nonas-hunter/3D-scanner/docs/MP2_PIE.pdf

# Mini-Project 2: DIY 3D Scanner

## Elisa Dhanger, Jennifer Lee, Luke Nonas-Hunter

## Section 3+4: Group 58

9/16/21

### Abstract

In this project, we were tasked to create a mechanism that could scan a 3D object (in this case a cardboard cutout of a letter) and create a visualization for it. We used 2 servo sensors, an infrared distance sensor, and an Arduino for the electrical/mechanical component of this project. The mechanical support structures were 3D printed, and everything was coded in Arduino and python through VScode.

## 1 Procedure

## 1.1 Circuit

To begin, we started by connecting the necessary components to the Arduino. We were required to use two servo motors and an infrared distance sensor. We connected the servos to pin 9 and 10, and we connected the infrared distance sensor to analog pin 0 since we needed to receive a set of continuous data (Figure 1).

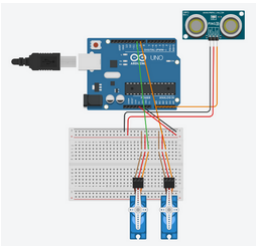
[picture p3: figure]

Figure 1: Circuit Diagram of setup.

After setting up the circuit, we started to run some calibration data for the sensor. The data that the Arduino was reading does not directly translate to distance, and in addition, we knew that the relationship between the analogRead() data and actual distance was not a direct linear relation. Therefore, we set up the sensor against a tape measure and recorded the analogRead() data at several distances across 0-28 inches into a spreadsheet and graphed out the data. Based on the results of these findings, we were able to calculate a line of best fit which would serve as the calibration curve (Figure 2).

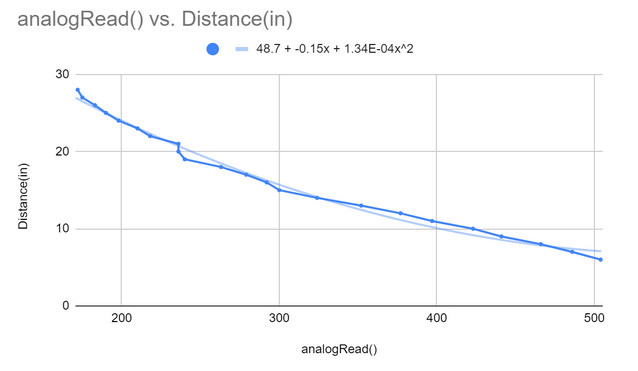
[picture p4: figure]

Figure 2: Calibration plot depicting relationship between the analogRead() data and the actual distance.

After setting up our calibration curve, we also were tasked to create an error plot to test how accurate the calibration curve is by taking measurements at certain distances and comparing the analogRead value for the actual distance vs. the predicted distance through the line of best fit (Figure 3). We had come to the conclusion that the distance was pretty accurate based on how low the error is, and that we could continue onto the next step.

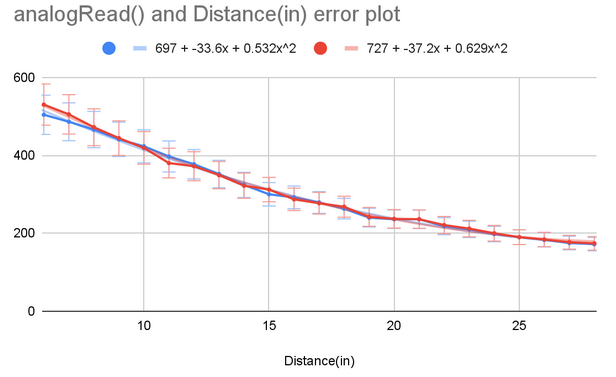
[picture p5: figure]

Figure 3: Error plot of calibration data.

## 1.2 Mechanism

For the 3D scanner, we had to build a pan-tilt mechanism to allow the infrared distance sensor to record distances from different yaws and pitches. This allows us to have enough data points to build a visualization of the object scanned.
To create the pan-tilt mechanism we started by creating sketches (Figure 4) of different pan-tilt mechanisms. We then used those sketches to start creating the CAD in SolidWorks. We started by creating the base of the pan-tilt (part 1) and our first iteration had the servo motor body centered in a cylinder (Figure 5).

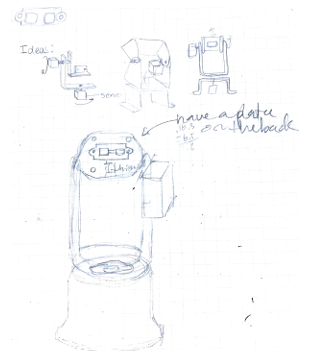
[picture p6: figure]

Figure 4: Sketches of different possible pan-tilt ideas to build.

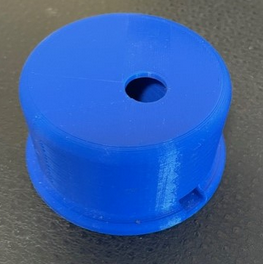
[picture p7: figure]

Figure 5: Part 1 with the servo motor centered and the shaft off-center (3D printed).

We realized after printing the piece that having the servo motor centered caused the shaft to be off-center meaning the next part of the pan-tilt that attached to the shaft would spin off-center. To fix this we centered the shaft of the servo motor (Figure 6).

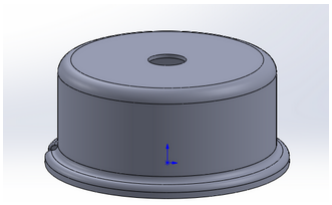
[picture p8: figure]

Figure 6: SolidWorks CAD model of part 1 with a centered shaft.

After creating the base we began designing the part that attaches to the shaft of the first servo motor (part 2). This part was made to have two arms that come up from the sides that have a hole on one side for a metal pin and a hole on the other side for the shaft of the servo motor. These would make it able to be able to hold and have the sensor-holder (part 3) rotate (pitch). We also added a motor case on one side of the part to better hold the second servo motor and have a place to screw it into the device. The first iteration of this part was too bulky (Figure 7) and so we redesigned this part to be thinner and not have a fully circular base but only a section of a circle (Figure 8).

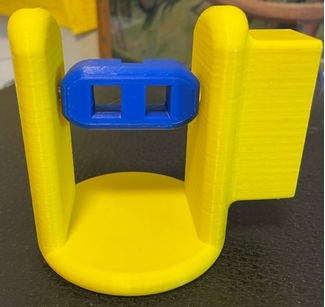
[picture p9: figure]

Figure 7: Part 2 edition 1 with thicker arms and a round base.

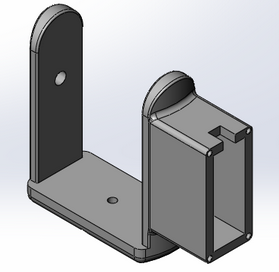
[picture p10: figure]

Figure 8: SolidWorks CAD model of part 2 with thinner arms and a cut-down base.

To then hold and rotate the sensor we created a sensor-holder that has a spot to screw the servo motor’s horn to the sensor holder. It also has a spot to press-fit the metal pin through part 2 to part 3 (Figure 9).

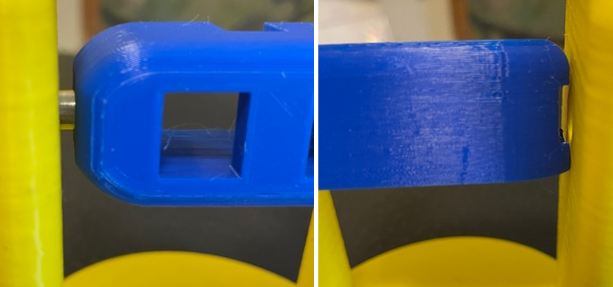
[picture p11: figure]

Figure 9: On left shows where the metal pin con-nects part 2 and part 3 together. On right shows where the motor horn would meet with part 3.

Due to the fact we redesigned part 2 we then had to redesign part 3 to be longer so it would fit better with the thinner part 2 (Figure 10).

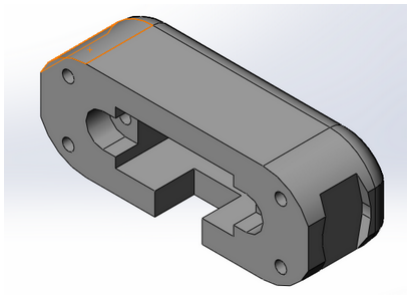
[picture p12: figure]

Figure 10: Final SolidWorks CAD model of part 3: the sensor holder.

For final touches, we created two covers, one for the sensor holder and one for part 2’s servo motor holder (Figure 11).

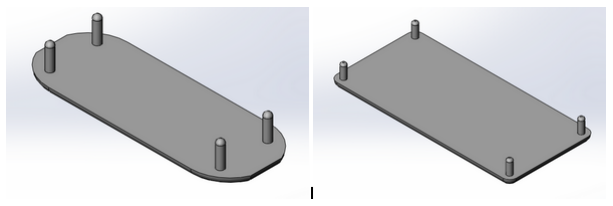
[picture p13: figure]

Figure 11: On the left is the sensor cover for part
3. On the right is the servo motor cover for part 2.

Throughout this process, we created an assembly that allowed us to make sure that parts we lining up correctly and fit together. We have Figure 12 to show the final assembly in SolidWorks of all of the parts mated together.

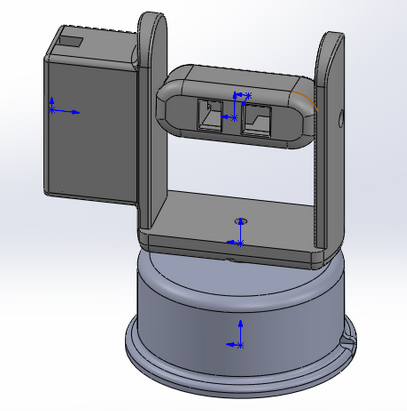
[picture p14: figure]

Figure 12: Shows the full assembly of parts 1,2,3 and the sensor and servo motor covers .

To fabricate the parts we used 3D printing because each of the parts are strangely shaped and hard to manufacture in traditional means. 3D printing also allowed us to quickly test out parts and find our mistakes faster.

## 1.3 Code

### 1.3.1 Software Architecture

Before we even opened our computers to start coding, we all sat in front of a whiteboard and created a system diagram for the software architecture as shown in Figure 13.
During the discussion of our software architecture, we decided we wanted to do as much pro-cessing in python as possible and have the Arduino act only as a bridge between Python and the physical components of the scanner. If we compare our scanner to a human body, then the python code would be like the brain, the Arduino would be the spinal cord/sensor neurons, the infrared distance sensor would be the eyes, and the servos would be the muscles. The python code would gather information from the user (like image resolution) and generate all the servo positions for each point in the final image. Then it would individually send those servo positions to the Arduino, wait for the Arduino to update the servos, and finally ask the Arduino to collect data from the IR distance sensor and send it back to Python using serial communication. Python would repeat these steps for every servo position. Once all the data has been collected, python would convert the raw data into meaningful measurements using a calibration curve we created and graph all the scanned points on a 3 axis plot which it presents to the user. To make it easier to code all the different tasks Python needed to be responsible for, we divided the tasks into three main groups: setup, communication, and visualization. If we expand on our human body analogy, the different parts of the Python code could be thought of as the different parts of the brain where each part specializes in a different function and all need to work together for the system to function.
In reflection, we found it incredibly helpful to have defined the system architecture so early in the project. Aside from it allowing us to divide the coding work up between the three of us

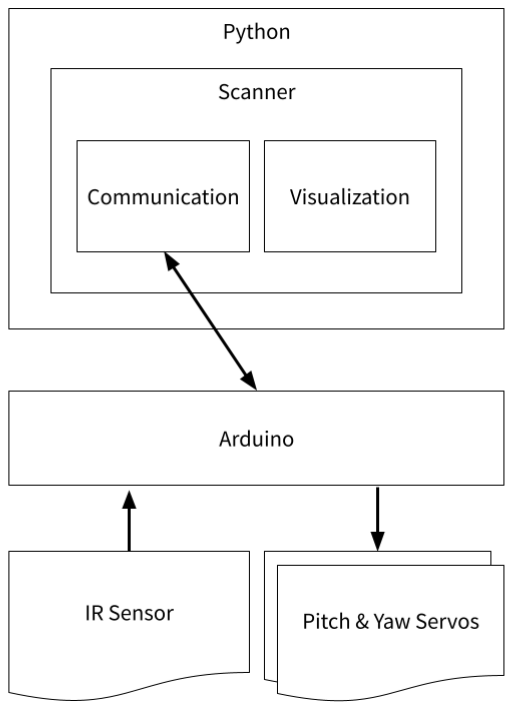
[picture p15: figure]

Figure 13: Software architecture diagram.

and work on it in parallel, it made the integration process much less painful because the inputs, outputs, and responsibilities of each code section were clearly defined.

### 1.3.2 Implementing Arduino-Python Communication

Once we started coding, we decided to start by tackling the Arduino-Python communication. We started implementing this first because it felt like the most mission-critical piece to us.
We start by just trying to get Python to send a message to the Arduino and have the Arduino blink a light when it received a message.
1 | import serial
2 | import time

3
4 arduino = serial . Serial ( port ="/dev/ ttyACM4 ", baudrate =115200 , timeout =5)

5
6 | while True :
7 | for _ in range (25) :
8 | arduino . write ( bytes (" TEST MESSAGE ", ’utf -8 ’) )
9 | time . sleep (3)
1 | void setup () {
2 | /* The setup function starts serial communcation , sets up a debug LED.
3 | */
4 | Serial . begin (115200) ;
5 | Serial . flush () ;
6 | pinMode ( LED_BUILTIN , OUTPUT ) ;
7 | digitalWrite ( LED_BUILTIN , LOW ) ;
8 | }

9
10 | void loop () {
11 | /* The main loop reads incoming serial messages . If a message is detected in
| the
12 | * input buffer , an LED is blinked on.

13 | */
14 | if ( Serial . available () > 0) {
15 | digitalWrite ( LED_BUILTIN , HIGH ) ;
16 | delay (100)
17 | } else {
18 | digitalWrite ( LED_BUILTIN , LOW ) ;
19 | }
20 | }

Once we were successfully receiving a message from the Arduino, we wrote code so the Arduino could respond to these messages.

1 | import serial
2 | import time

3
4 arduino = serial . Serial ( port ="/dev/ ttyACM4 ", baudrate =115200 , timeout =5)

5
6 | while True :
7 | for _ in range (25) :
8 | arduino . write ( bytes (" TEST MESSAGE ", ’utf -8 ’) )
9 | print ( arduino . read_until ( bytes ("\r\n", ’utf -8 ’) ) . decode ("utf -8") )
10 | time . sleep (3)
1 | void sendMessage ( String messageData ) {
2 | /* Send a message to python using serial
3 | *
4 | * Parameters :
5 | * messageData ( String ): the message data to be sent .
6 | */
7 | Serial . println ( messageData ) ;
8 | }

9
10 | void setup () {
11 | /* The setup function starts serial communcation , sets up a debug LED.
12 | */
13 | Serial . begin (115200) ;
14 | Serial . flush () ;
15 | pinMode ( LED_BUILTIN , OUTPUT ) ;
16 | digitalWrite ( LED_BUILTIN , LOW ) ;
17 | }

18
19 | void loop () {
20 | /* The main loop reads incoming serial messages . If a message is detected in
| the
21 | * input buffer , an LED is blinked on.
22 | */
23 | if ( Serial . available () > 0) {
24 | digitalWrite ( LED_BUILTIN , HIGH ) ;
25 | String message = Serial . readStringUntil (’\n’) ;
26 | sendMessage ( message ) ;
27 | } else {
28 | digitalWrite ( LED_BUILTIN , LOW ) ;
29 | }
30 | }

Getting to this point was super exciting for our team. This was the core mechanism behind our system and having it working felt great. At this point, we spent some time trying to implement some best practices when it comes to writing in Python. We grouped our code into reusable classes and functions, wrote comments, utilized the logging Python package to add some debug statements to our code, and added raise statements to catch if any unexpected values were trying to be sent or received over serial.
We also spent some time formalizing the message protocol we wanted to use. We decided that every message was going to start with a message type. The type would be represented by one character that indicated the kind of data that was going to follow. ’M’ meant that the message contained servo positions, ’S’ meant the message was trying to request IR distance sensor data, and ’T’ was a test message with arbitrary data to check serial communication was working properly. Each message would also end with a specific series of end-of-message characters, specifically, ’\r\n’. We choose these characters because they are automatically printed to the serial bus by the Arduino when using the Serial.println() function.

### At this point our code looked something like this:

1 | import time
2 | import logging
3 | import logging . config
4 | import serial

5
6 | logger_path = os . path . join ( os . path . dirname ( os . path . abspath ( __file__ ) ) , ’logging .
| conf ’)
7 | logging . config . fileConfig ( logger_path , disable_existing_loggers = False )
8 | logger = logging . getLogger ( __name__ )
9 | logger . setLevel ( logging . DEBUG )

10
11 | class Communication () :
12 | """ Infrastructure for serial communication with the Arduino ."""

13
14 | EOM = "\r\n"
15 | SEND_MESSAGE_TYPES = ["M", "S", "T"]
16 | RECIEVE_MESSAGE_TYPES = ["M", "S","T"]

17
18 | def __init__ ( self , baudrate =115200 , port ="/dev / ttyACM4 ") :
19 | """ Instantiate a Communication object .

20
21 | Parameters :
22 | baudrate (int): the baudrate of the serial port . This should match the
23 | baudrate set on the Arduino .
24 | port ( str): the serial port where the Arduino is connected .
25 | """

26
27 | logger . info (" Starting communication with Arduino ...")
28 | self . arduino = serial . Serial ( port = port , baudrate = baudrate , timeout =5)
29 | time . sleep (5)
30 | self . arduino . flush ()
31 | response = self . send_recieve ("T"," 12345 ")
32 | if response [" data "] == " 12345 ":
33 | logger . info (" Serial communication ready !")
34 | else :
35 | logger . info ( f" ERROR : { response }")

36

37
38 | def send ( self , message_type , message_data ) :
39 | """ Send data to the arduino .

40
41 | Parameters :
42 | message_type ( str): the message type . Must be a type listed in the
| send
43 | message type list stored in the communications class .

44 | message_data ( str): data to be sent over the serial bus to the Arduino

45
46 | Raises :
47 | ValueError : when the message type does not match a message type listed
48 | in the SEND_MESSAGE_TYPES list .
49 | """
50 | if message_type not in self . SEND_MESSAGE_TYPES :
51 | raise ValueError ( f" Incorrect message type : { message_type }")
52 | message = f"{ message_type }{ message_data }{ self .EOM}"
53 | self . arduino . write ( bytes ( message , ’utf -8 ’) )

54

55
56 | def receive ( self ) :
57 | """ Receive data from the arduino .

58
59 | Returns :
60 | ( dict ): contains message type , processed data , and error value .
61 | """
62 | raw_data = self . arduino . read_until ( bytes ( self . EOM , ’utf -8 ’) ) . decode ("utf -8
| ")
63 | try :
64 | message_type = raw_data [0]
65 | except IndexError :
66 | return {
67 | " message_type ": " ERROR ",
68 | " data ": " EMPTY ",
69 | " error ": 2 ,
70 | }
71 | if message_type in self . RECIEVE_MESSAGE_TYPES :
72 | data = raw_data . split ("\n") [0]. split ("\r") [0][1:]
73 | return {
74 | " message_type ": message_type ,
75 | " data ": data ,
76 | " error ": 0 ,
77 | }
78 | else :
79 | return {
80 | " message_type ": " ERROR ",
81 | " data ": raw_data ,
82 | " error ": 1 ,
83 | }

84
85 | def send_recieve ( self , message_type , message_data ) :
86 | """ Send data and expect a response .

87
88 | Parameters :
89 | message_type ( str): the message type . Must be a type listed in the
| send
90 | message type list stored in the communications class .
91 | message_data ( str): data to be sent over the serial bus to the Arduino
92 | Returns :
93 | ( dict ): contains message type , processed data , and error value .
94 | """
95 | self . send ( message_type , message_data )
96 | response = self . receive ()
97 | if response [" message_type "] != message_type :
98 | raise ValueError ( f" Unexpected message type . Message : { response }")

99 | | return response
1 | # define TYPE_INDEX 0
2 | # define DATA_INDEX 1

3
4 | void sendMessage ( char messageType , String messageData ) {
5 | /* Send a message to python using serial
6 | *
7 | * Parameters :
8 | * | messageType ( char ): the type of the message . Examples include , ’M’ for
9 | * | motor response , ’S’ for sensor response , or ’T’ for test .
10 | * messageData ( String ): the message data to be sent .
11 | */
12 | Serial . print ( messageType ) ;
13 | Serial . println ( messageData ) ;
14 | }

15
16 | void setup () {
17 | /* The setup function starts serial communcation , sets up a debug LED.
18 | */
19 | Serial . begin (115200) ;
20 | Serial . flush () ;
21 | pinMode ( LED_BUILTIN , OUTPUT ) ;
22 | digitalWrite ( LED_BUILTIN , LOW ) ;
23 | }

24
25 | void loop () {
26 | /* The main loop reads incoming serial messages . If a message is detected in
| the
27 | * input buffer , an LED is blinked on.
28 | */
29 | if ( Serial . available () > 0) {
30 | | digitalWrite ( LED_BUILTIN , HIGH ) ;
31 | | String message = Serial . readStringUntil (’\n’) ;
32 | | char messageType = message . charAt ( TYPE_INDEX ) ;
33 | | String data = message . substring ( DATA_INDEX ) ;
34 | | sendMessage ( message ) ;
35 | } else {
36 | | digitalWrite ( LED_BUILTIN , LOW ) ;
37 | }
38 | }

### 1.3.3 Controlling Servos and Getting IR Distance Data

Our next step was to write Arduino code that would either set servo positions or read the IR distance sensor. However, before we could start messing around with the sensor and motors, we needed to build the infrastructure that was going to decipher and execute the commands from Python. This required manipulating the raw message string being received by the Arduino from the serial bus. Specifically, we wanted to isolate the message type and the message data. Once the Arduino knows the message type, it can easily decide how to handle the rest of the message and generate a response to send back. We implemented this using the charAt() function and a switch

### statement. The code is shown below:

1 | # define TYPE_INDEX 0
2 | # define DATA_INDEX 1

3
4 void sendMessage ( char messageType , String messageData ) {

5 | /* Send a message to python using serial
6 | *
7 | * Parameters :
8 | * | messageType ( char ): the type of the message . Examples include , ’M’ for
9 | * | motor response , ’S’ for sensor response , or ’T’ for test .
10 | * messageData ( String ): the message data to be sent .
11 | */
12 | Serial . print ( messageType ) ;
13 | Serial . println ( messageData ) ;
14 | }

15
16 | void analyzeMessage ( String message ) {
17 | /* Decode serial messages from python and execute corresponding
18 | * response function and returns the response .
19 | *
20 | * Parameters :
21 | * | message ( String ): the raw message sent over serial from python .
22 | */
23 | char messageType = message . charAt ( TYPE_INDEX ) ;
24 | String data = message . substring ( DATA_INDEX ) ;
25 | String response ;
26 | switch ( messageType ) {
27 | | case ’M’:
28 | | response = " MOTOR ";
29 | | sendMessage (’M’, response ) ;
30 | | break ;
31 | | case ’S’:
32 | | response = " SENSOR ";
33 | | sendMessage (’S’, response ) ;
34 | | break ;
35 | | case ’T’:
36 | | sendMessage (’T’, " 12345 ") ;
37 | | break ;
38 | }
39 | }

40
41 | void setup () {
42 | /* The setup function starts serial communcation , sets up a debug LED.
43 | */
44 | Serial . begin (115200) ;
45 | Serial . flush () ;
46 | pinMode ( LED_BUILTIN , OUTPUT ) ;
47 | digitalWrite ( LED_BUILTIN , LOW ) ;
48 | }

49
50 | void loop () {
51 | /* The main loop reads incoming serial messages and sends them
52 | * to the analyzeMessage function where they are decoded and the
53 | * proper actions are taken .
54 | */
55 | if ( Serial . available () > 0) {
56 | | digitalWrite ( LED_BUILTIN , HIGH ) ;
57 | | String message = Serial . readStringUntil (’\n’) ;
58 | | analyzeMessage ( message ) ;
59 | } else {
60 | | digitalWrite ( LED_BUILTIN , LOW ) ;
61 | }
62 | }

Now that the infrastructure was in place, we were ready to write functions to interact with servos and sensor. For the servo code, we relied heavily on the Servo C++ package. It includes functions like servo.attach(pin) which set up a PWM compatible pin so it can provide a PWM signal to the servos and servo.write(angle) which turns the shaft so it is angle degrees away from the starting/zero point. For the IR sensor, we just used the analogRead() function to get raw data from the sensor. At this point, we did not worry about applying the calibration curve equation for filtering the data because we felt those were all things that could be done in Python. The new

### Arduino code was as follows:

1 | # define TYPE_INDEX 0
2 | # define DATA_INDEX 1
3 | # define PITCH_SERVO_PIN 9
4 | # define YAW_SERVO_PIN 10
5 | # define DISTANCE_SENSOR_PIN 0
6 | # include < Servo .h >

7
8 | Servo pitchServo ;
9 | Servo yawServo ;

10
11 | int current_pitch ;
12 | int current_yaw ;

13
14 | bool setServoPosition ( int pitch , int yaw ) {
15 | /* Set the servos to the given pitch and yaw.
16 | *
17 | * Parameters :
18 | * | pitch (int): PWM value for setting the angle of the pitch motor shaft .
19 | * | yaw (int): PWM value for setting the angle of the yaw motor shaft .
20 | *
21 | * Returns :
22 | * | ( bool ): success of motor update
23 | */
24 | yawServo . write ( yaw ) ;
25 | pitchServo . write ( pitch ) ;
26 | return true ;
27 | }

28
29 | String respondSensorMessage ( String message ) {
30 | /* Decodes sensor command messages and generates response .
31 | *
32 | * Parameters :
33 | * | message ( String ): Data from sensor message sent over serial from python .
34 | *
35 | * Returns :
36 | * | ( String ): message to be sent as a response
37 | */
38 | String response = "";
39 | int distance ;
40 | distance = analogRead ( DISTANCE_SENSOR_PIN ) ;
41 | return String ( distance ) ;
42 | }

43
44 | String respondServoMessage ( String message ) {
45 | /* Decodes motor command messages and generates response .
46 | *
47 | * Parameters :
48 | * | message ( String ): Data from motor message sent over serial from python .
49 | *

50 | * Returns :
51 | * | ( String ): message to be sent as a response
52 | */
53 | int pitch = message . substring (0 , 3) . toInt () ;
54 | int yaw = message . substring (4 , 7) . toInt () ;
55 | setServoPosition ( pitch , yaw ) ;
56 | return true ;
57 | }

58
59 | void sendMessage ( char messageType , String messageData ) {
60 | /* Send a message to python using serial
61 | *
62 | * Parameters :
63 | * | messageType ( char ): the type of the message . Examples include , ’M’ for
64 | * | motor response , ’S’ for sensor response , or ’T’ for test .
65 | * messageData ( String ): the message data to be sent .
66 | */
67 | Serial . print ( messageType ) ;
68 | Serial . println ( messageData ) ;
69 | }

70
71 | void analyzeMessage ( String message ) {
72 | /* Decode serial messages from python and execute corresponding
73 | * response function and returns the response .
74 | *
75 | * Parameters :
76 | * | message ( String ): the raw message sent over serial from python .
77 | */
78 | char messageType = message . charAt ( TYPE_INDEX ) ;
79 | String data = message . substring ( DATA_INDEX ) ;
80 | String response ;
81 | switch ( messageType ) {
82 | | case ’M’:
83 | | response = respondServoMessage ( data ) ;
84 | | sendMessage (’M’, response ) ;
85 | | break ;
86 | | case ’S’:
87 | | response = respondSensorMessage ( data ) ;
88 | | sendMessage (’S’, response ) ;
89 | | break ;
90 | | case ’T’:
91 | | sendMessage (’T’, " 12345 ") ;
92 | | break ;
93 | }
94 | }

95
96 | void setup () {
97 | /* The setup function starts serial communcation , sets up a debug LED , and
98 | * assigns PWM pins to servos .
99 | */
100 | Serial . begin (115200) ;
101 | Serial . flush () ;
102 | pinMode ( LED_BUILTIN , OUTPUT ) ;
103 | digitalWrite ( LED_BUILTIN , LOW ) ;

104
105 | pitchServo . attach ( PITCH_SERVO_PIN ) ;
106 | yawServo . attach ( YAW_SERVO_PIN ) ;
107 | current_pitch = 0;
108 | current_yaw = 0;

109 | setServoPosition ( current_pitch , current_yaw ) ;
110 | }

111
112 | void loop () {
113 | /* The main loop reads incoming serial messages and sends them
114 | * to the analyzeMessage function where they are decoded and the
115 | * proper actions are taken .
116 | */
117 | if ( Serial . available () > 0) {
118 | digitalWrite ( LED_BUILTIN , HIGH ) ;
119 | String message = Serial . readStringUntil (’\n’) ;
120 | analyzeMessage ( message ) ;
121 | } else {
122 | digitalWrite ( LED_BUILTIN , LOW ) ;
123 | }
124 | }

At this point, our Arduino code had reached its minimum viable product. It could read commands from Python, execute those commands by setting the angle of the servos or reading sensor data and then send a response with the relevant data. However, while the basic functionality was great, there was still more work that had to be done. We’ll discuss some of these changes in the filtering section.

### 1.3.4 Scanning a Line

At this point, we felt like we should try running a more rigorous test to make sure everything we had done so far was working. We decided that we wanted to try sweeping a yaw value across one pitch value and observe the outcome. We set up the scanner in front of a wall so that we knew exactly what to expect: a straight line. But before we were able to perform the test, we needed to write the Python infrastructure that would allow us to sweep across points, get sensor data, and display visuals.
Our first step was to write the Scanner class which contains functions that allow it to send motor position requests and sensor data requests to the Arduino. These functions also use the calibration data we collected earlier to translate the raw data into meaningful data and vice-versa. For example, it’s intuitive to want to sweep over values centered on zero however when the scanner was pointing perfectly forward, it was actually at (150, 90) which means that we will need to offset all of the servo positions so that the angles sent to the Arduino are actual angles rather than relative angles to the scanners (0,0) position. For the sensor data, we used the equation we calculated earlier in the report to convert the raw sensor data into inches.
1 | import time
2 | import logging
3 | import logging . config
4 | import os

5
6 | import numpy as np
7 | from scanviz . communication import Communication

8
9 | logger_path = os . path . join ( os . path . dirname ( os . path . abspath ( __file__ ) ) , ’logging .
| conf ’)
10 | logging . config . fileConfig ( logger_path , disable_existing_loggers = False )
11 | logger = logging . getLogger ( __name__ )
12 | logger . setLevel ( logging . DEBUG )

13
14 class Scanner () :

15 | """ API for interfacing with the scanner """

16
17 | def __init__ ( self ) :
18 | self . comms = Communication ()

19
20 | def set_position ( self , pitch , yaw ) :
21 | """ Send a message to the Arduino to set the pitch and roll of the Scanner .

22
23 | Parameters :
24 | pitch ( float ): Representing the desired pitch angle .
25 | yaw ( float ): Representing the desired yaw angle .
26 | """
27 | adjusted_pitch = pitch + 150
28 | adjusted_yaw = - yaw + 90
29 | if adjusted_pitch > 180 or adjusted_yaw > 180:
30 | raise ValueError (" Cannot send motor angles greater than 180 deg.")
31 | logger . debug (
32 | " Setting servo positions to ( pitch )"
33 | f" {int( round ( adjusted_pitch ))} , (yaw) {int( round ( adjusted_yaw ))}."
34 | )
35 | message = f"{int ( round ( adjusted_pitch )):03 d}+{ int ( round ( adjusted_yaw )) :03d
| }"
36 | response = self . comms . send_recieve ("M", message )
37 | if int( response [" data "]) == 0:
38 | raise ValueError (" Servo did not respond . Stopping program .")
39 | else :
40 | time . sleep ( int( response [" data "]) /10)
41 | logger . debug (" Servo positions have been set.")

42
43 | def get_distance ( self ) :
44 | """ Send a message to Arduino to send three distance measurements over
| serial .

45
46 | Returns :
47 | ( float ): Calibrated output from distance sensor in inches .
48 | """
49 | logger . debug (" Getting measured sensor distance .")
50 | response = self . comms . send_recieve ("S", "GET")
51 | logger . debug ( f" Information recieved : { response [ ’ data ’]}")
52 | raw_data = response [" data "]. split (",")
53 | output = []
54 | for data in raw_data :
55 | output += [48.7 - (0.15 * int( data ) ) + (0.000134 * ( int( data ) **2) ) ]
56 | return output

Once that was done, we wrote the Visualization class which contains functions that allow it to generate a mesh of all the points we want to scan and allow it to graph the collected data points using matplotlib. At this point, we were only trying to scan a line so we only needed to sweep across one variable while keeping the other one constant. However, rather than creating one variable for the dimension we were sweeping across, we still defined both dimensions as variables. For the pitch, we assigned it to be a constant while the other was a list of points. We pretended that the constant variable was a list of points and wrote the rest of the code to try and accommodate that. This included figuring out the math to translate the spherical coordinates being produced by the scanner from the servo positions and the measured distance into cartesian coordinates rather than just plotting the polar data we were generating. While this was more work at the moment, implementing the math at this point made it so much easier to jump from scanning just a line to

### a mesh of points. Below is the code we wrote:

1 | import logging
2 | import logging . config
3 | import os

4
5 | import numpy as np
6 | import scipy . signal as scipy
7 | import matplotlib . pyplot as plt
8 | from matplotlib import ticker , cm

9
10 | logger_path = os . path . join ( os . path . dirname ( os . path . abspath ( __file__ ) ) , ’logging .
| conf ’)
11 | logging . config . fileConfig ( logger_path , disable_existing_loggers = False )
12 | logger = logging . getLogger ( __name__ )
13 | logger . setLevel ( logging . DEBUG )

14
15 | class Visualization () :
16 | """ Tools for visualizing scanner data ."""
17 | def __init__ ( self ) :
18 | """ Instantiate visualization object """
19 | pass

20
21 | def generate_mesh ( self , resolution ) :
22 | """ Generate pitch & yaw angles for scanning

23
24 | Parameters :
25 | resolution (int): Number of points to scan
26 | Returns :
27 | ( list ): List of lists outlining all the yaw values to scan .
28 | (int): Integer representing the pre -set pitch for all measurements .
29 | """
30 | if resolution > 60:
31 | raise ValueError (" Resolution can ’t be higher than 180")
32 | pitch = np . linspace ( -30 , 30 , resolution )
33 | yaw = [150]
34 | pitch_mesh , yaw_mesh = np . meshgrid ( pitch , yaw )
35 | return pitch_mesh , yaw_mesh

36
37 | def create_viz ( self , pitch , yaw , radius ) :
38 | """ Create a matplotlib graph to visualize the data ."""
39 | pitch_rad = np . deg2rad ( pitch )
40 | yaw_rad = np . deg2rad ( yaw )
41 | x = radius * np . sin ( yaw_rad ) * np . cos ( pitch_rad )
42 | y = radius * np . sin ( pitch_rad )
43 | z = radius * np . cos ( pitch_rad ) * np . cos ( yaw_rad )

44
45 | fig = plt . figure ( figsize = plt . figaspect (2.) )
46 | fig . suptitle (’3D Scan ’)

47
48 | # 3D Render
49 | ax_3D = fig . add_subplot ( projection =’3d’)

50
51 | surf = ax_3D . scatter (
52 | x ,
53 | z ,
54 | y ,
55 | )

56

57 | fig . tight_layout ()
58 | plt . show ()

Finally, we wrote a sweep() function which lives in the Scanner class and sweeps through all the points generated by the Visualization class, collects data at each point using the rest of the Scanner class and Communication class, and then sends that data to the create_viz() function to produce a final output image. The code for the sweep() function is shown below.

1 | def sweep ( self , resolution ) :
2 | """ Sweep over a set of pitch and yaw values and collect distance data .

3
4 | Parameters :
5 | resolution (int): Determines the number of measurements taken by the
6 | sensor . The number of measurements equals (2*( resolution **2) ).
7 | """
8 | logger . info ( f" Scan Beginning . Estimated Time : {(( resolution **2) *1.5) /60} ")
9 | pitch_mesh , yaw_mesh = self . viz . generate_mesh ( resolution )
10 | radius_mesh = []
11 | for row in range (len ( pitch_mesh ) ) :
12 | radius_mesh_row = []
13 | for col in range (len ( pitch_mesh [ row ]) ) :
14 | self . set_position ( pitch_mesh [ row ][ col ] , yaw_mesh [ row ][ col ])
15 | radius_mesh_row += [ self . get_distance () ]
16 | radius_mesh += [ radius_mesh_row ]
17 | self . viz . create_viz ( pitch_mesh , yaw_mesh , radius_mesh )

Once all the code had been written we ran the function and generated our first scan! The results are shown in Figure 14.


Figure 14: Single line from a scan of a wall.

While there was some noise and random outliers, for the most part, it was clear we had scanned a flat wall. This test made us realize that we were going to need to apply a filter to the data to help remove noise and reduce outliers.

### 1.3.5 Scanning a Mesh

Thanks to the extra work we did while taking a scan of just a line, we were able to easily make the jump to scanning a 2D grid of points very easy. All we had to do was change one line of code from

### defining the pitch as a single number to defining it as a list of points as shown below:

1 pitch = np . linspace ( -30 , 30 , resolution )

At this point, we had fully completed the minimum-viable product we were hoping to achieve. We set up our letter and took our first ten by ten image scan. The results are shown in Figure 15

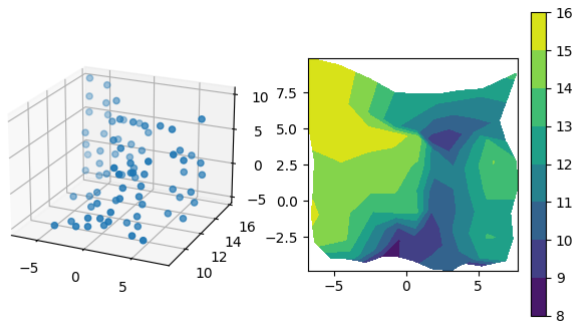
[picture p16: figure]

Figure 15: A low resolution (10 point by 10 point) scan of the letter J against a wall.

### 1.3.6 Filtering

Looking at our first scan, it was mostly clear that we had scanned the letter J however there was still noise and random outliers. To fix these problems we did two things. The first one was to modify the Arduino data collection code to collect multiple scans of the same location rather than just one. This would allow the python code to take the average of the many scans and hopefully reduce the number of outliers in the final image. The second one was to apply a convolution filter to the final image using the scipy package. A convolution filter takes a matrix smaller than the original image and slides it across the image. For each grouping of points it slides over, it multiplies the group with the matrix and adds all the values which will represent one pixel in the filtered image. Ultimately, this filter would reduce the accuracy of the image, but also would help reduce any noise in the image. After all these changes were made, we had the final iteration of our code for the project.

1 | import time
2 | import logging
3 | import logging . config
4 | import serial

5
6 import numpy as np

7 | import scipy . signal as scipy
8 | import matplotlib . pyplot as plt
9 | from matplotlib import ticker , cm

10
11 | logger_path = os . path . join ( os . path . dirname ( os . path . abspath ( __file__ ) ) , ’logging .
| conf ’)
12 | logging . config . fileConfig ( logger_path , disable_existing_loggers = False )
13 | logger = logging . getLogger ( __name__ )
14 | logger . setLevel ( logging . DEBUG )

15
16 | class Communication () :
17 | """ Infrastructure for serial communication with the Arduino ."""

18
19 | EOM = "\r\n"
20 | SEND_MESSAGE_TYPES = ["M", "S", "T"]
21 | RECIEVE_MESSAGE_TYPES = ["M", "S","T"]

22
23 | def __init__ ( self , baudrate =115200 , port ="/dev / ttyACM4 ") :
24 | """ Instantiate a Communication object .

25
26 | Parameters :
27 | baudrate (int): the baudrate of the serial port . This should match the
28 | baudrate set on the Arduino .
29 | port ( str): the serial port where the Arduino is connected .
30 | """

31
32 | logger . info (" Starting communication with Arduino ...")
33 | self . arduino = serial . Serial ( port = port , baudrate = baudrate , timeout =5)
34 | time . sleep (5)
35 | self . arduino . flush ()
36 | response = self . send_recieve ("T"," 12345 ")
37 | if response [" data "] == " 12345 ":
38 | logger . info (" Serial communication ready !")
39 | else :
40 | logger . info ( f" ERROR : { response }")

41

42
43 | def send ( self , message_type , message_data ) :
44 | """ Send data to the arduino .

45
46 | Parameters :
47 | message_type ( str): the message type . Must be a type listed in the
| send
48 | message type list stored in the communications class .
49 | message_data ( str): data to be sent over the serial bus to the Arduino

50
51 | Raises :
52 | ValueError : when the message type does not match a message type listed
53 | in the SEND_MESSAGE_TYPES list .
54 | """
55 | if message_type not in self . SEND_MESSAGE_TYPES :
56 | raise ValueError ( f" Incorrect message type : { message_type }")
57 | message = f"{ message_type }{ message_data }{ self .EOM}"
58 | self . arduino . write ( bytes ( message , ’utf -8 ’) )

59

60
61 | def receive ( self ) :
62 | """ Receive data from the arduino .

63
64 | Returns :
65 | ( dict ): contains message type , processed data , and error value .
66 | """
67 | raw_data = self . arduino . read_until ( bytes ( self . EOM , ’utf -8 ’) ) . decode ("utf -8
| ")
68 | try :
69 | message_type = raw_data [0]
70 | except IndexError :
71 | return {
72 | " message_type ": " ERROR ",
73 | " data ": " EMPTY ",
74 | " error ": 2 ,
75 | }
76 | if message_type in self . RECIEVE_MESSAGE_TYPES :
77 | data = raw_data . split ("\n") [0]. split ("\r") [0][1:]
78 | return {
79 | " message_type ": message_type ,
80 | " data ": data ,
81 | " error ": 0 ,
82 | }
83 | else :
84 | return {
85 | " message_type ": " ERROR ",
86 | " data ": raw_data ,
87 | " error ": 1 ,
88 | }

89
90 | def send_recieve ( self , message_type , message_data ) :
91 | """ Send data and expect a response .

92
93 | Parameters :
94 | message_type ( str): the message type . Must be a type listed in the
| send
95 | message type list stored in the communications class .
96 | message_data ( str): data to be sent over the serial bus to the Arduino
97 | Returns :
98 | ( dict ): contains message type , processed data , and error value .
99 | """
100 | self . send ( message_type , message_data )
101 | response = self . receive ()
102 | if response [" message_type "] != message_type :
103 | raise ValueError ( f" Unexpected message type . Message : { response }")
104 | return response

105
106 | class Scanner () :
107 | """ API for interfacing with the scanner """

108
109 | def __init__ ( self ) :
110 | self . comms = Communication ()
111 | self . viz = Visualization ()

112
113 | def set_position ( self , pitch , yaw ) :
114 | """ Send a message to the Arduino to set the pitch and roll of the Scanner .

115
116 | Parameters :
117 | pitch ( float ): Representing the desired pitch angle .
118 | yaw ( float ): Representing the desired yaw angle .

119 | """
120 | adjusted_pitch = pitch + 150
121 | adjusted_yaw = - yaw + 90
122 | if adjusted_pitch > 180 or adjusted_yaw > 180:
123 | raise ValueError (" Cannot send motor angles greater than 180 deg.")
124 | logger . debug (
125 | " Setting servo positions to ( pitch )"
126 | f" {int( round ( adjusted_pitch ))} , (yaw) {int( round ( adjusted_yaw ))}."
127 | )
128 | message = f"{int ( round ( adjusted_pitch )):03 d}+{ int ( round ( adjusted_yaw )) :03d
| }"
129 | response = self . comms . send_recieve ("M", message )
130 | if int( response [" data "]) == 0:
131 | raise ValueError (" Servo did not respond . Stopping program .")
132 | else :
133 | time . sleep ( int( response [" data "]) /10)
134 | logger . debug (" Servo positions have been set.")

135
136 | def get_distance ( self ) :
137 | """ Send a message to Arduino to send three distance measurements over
| serial .

138
139 | Returns :
140 | ( float ): Calibrated output from distance sensor in inches .
141 | """
142 | logger . debug (" Getting measured sensor distance .")
143 | response = self . comms . send_recieve ("S", "GET")
144 | logger . debug ( f" Information recieved : { response [ ’ data ’]}")
145 | raw_data = response [" data "]. split (",")
146 | output = []
147 | for data in raw_data :
148 | output += [48.7 - (0.15 * int( data ) ) + (0.000134 * ( int( data ) **2) ) ]
149 | logger . debug ( f" Measured Value : { sum( output )/ len( output )}")
150 | return sum ( output ) / len( output )

151
152 | def sweep ( self , resolution ) :
153 | """ Sweep over a set of pitch and yaw values and collect distance data .

154
155 | Parameters :
156 | resolution (int): Determines the number of measurements taken by the
157 | sensor . The number of measurements equals (2*( resolution **2) ).
158 | """
159 | logger . info ( f" Scan Beginning . Estimated Time : {(( resolution **2) *1.5) /60} ")
160 | pitch_mesh , yaw_mesh = self . viz . generate_mesh ( resolution )
161 | radius_mesh = []
162 | for row in range (len ( pitch_mesh ) ) :
163 | radius_mesh_row = []
164 | for col in range (len ( pitch_mesh [ row ]) ) :
165 | self . set_position ( pitch_mesh [ row ][ col ] , yaw_mesh [ row ][ col ])
166 | radius_mesh_row += [ self . get_distance () ]
167 | radius_mesh += [ radius_mesh_row ]
168 | self . viz . create_viz ( pitch_mesh , yaw_mesh , radius_mesh )

169
170 | class Visualization () :
171 | """ Tools for visualizing scanner data ."""
172 | def __init__ ( self ) :
173 | """ Instantiate visualization object """
174 | pass

175

176 | def generate_mesh ( self , resolution ) :
177 | """ Generate pitch & yaw angles for scanning

178
179 | Parameters :
180 | resolution (int): Number of points to scan
181 | Returns :
182 | ( list ): List of lists outlining all the pitch values to scan .
183 | ( list ): List of lists outlining all the yaw values to scan .
184 | """
185 | if resolution > 60:
186 | raise ValueError (" Resolution can ’t be higher than 180")
187 | pitch = np . linspace ( -30 , 30 , resolution )
188 | yaw = np . linspace ( -30 , 30 , resolution )
189 | pitch_mesh , yaw_mesh = np . meshgrid ( pitch , yaw )
190 | return pitch_mesh , yaw_mesh

191
192 | def _moving_avg ( self , data ) :
193 | window = np . ones ((2 , 2) ) / 4
194 | return scipy . convolve2d ( data , window , ’valid ’)

195
196 | def create_viz ( self , pitch , yaw , radius ) :
197 | """ Create a matplotlib graph to visualize the data ."""
198 | smooth_radius = self . _moving_avg ( radius )
199 | pitch_rad = [ row [1:] for row in np . deg2rad ( pitch ) [1: ,:]]
200 | yaw_rad = [ row [1:] for row in np . deg2rad ( yaw ) [1: ,:]]
201 | # Unfiltered Output
202 | # smooth_radius = radius
203 | # pitch_rad = np. deg2rad ( pitch )
204 | # yaw_rad = np. deg2rad (yaw)
205 | x = smooth_radius * np . sin ( yaw_rad ) * np . cos ( pitch_rad )
206 | y = smooth_radius * np . sin ( pitch_rad )
207 | z = smooth_radius * np . cos ( pitch_rad ) * np . cos ( yaw_rad )

208
209 | fig = plt . figure ( figsize = plt . figaspect (2.) )
210 | fig . suptitle (’3D Scan ’)

211
212 | # 2D Contour
213 | ax_2D = fig . add_subplot (1 , 2 , 2)

214
215 | contour = ax_2D . contourf (x , y , z )
216 | ax_2D . set_aspect (’equal ’, ’box ’)
217 | fig . colorbar ( contour , ax = ax_2D , shrink =0.5)

218
219 | # 3D Render
220 | ax_3D = fig . add_subplot (1 , 2 , 1 , projection =’3d’)

221
222 | surf = ax_3D . scatter (
223 | x ,
224 | z ,
225 | y ,
226 | )

227
228 | fig . tight_layout ()
229 | plt . show ()
1 | # define TYPE_INDEX 0
2 | # define DATA_INDEX 1
3 | # define PITCH_SERVO_PIN 9
4 | # define YAW_SERVO_PIN 10

5 | # define DISTANCE_SENSOR_PIN 0
6 | # include < Servo .h >

7
8 | Servo pitchServo ;
9 | Servo yawServo ;

10
11 | int current_pitch ;
12 | int current_yaw ;

13
14 | bool setServoPosition ( int pitch , int yaw ) {
15 | /* Set the servos to the given pitch and yaw.
16 | *
17 | * Parameters :
18 | * | pitch (int): PWM value for setting the angle of the pitch motor shaft .
19 | * | yaw (int): PWM value for setting the angle of the yaw motor shaft .
20 | *
21 | * Returns :
22 | * | ( bool ): success of motor update
23 | */
24 | yawServo . write ( yaw ) ;
25 | pitchServo . write ( pitch ) ;
26 | return true ;
27 | }

28
29 | String respondSensorMessage ( String message ) {
30 | /* Decodes sensor command messages and generates response .
31 | *
32 | * Parameters :
33 | * | message ( String ): Data from sensor message sent over serial from python .
34 | *
35 | * Returns :
36 | * | ( String ): message to be sent as a response
37 | */
38 | String response = "";
39 | int distance ;
40 | for (int i = 0; i <= 15; i ++) {
41 | | distance = analogRead ( DISTANCE_SENSOR_PIN ) ;
42 | | response += String ( distance , DEC ) + ",";
43 | }
44 | return response . substring (0 , response . length () - 1) ;
45 | }

46
47 | String respondServoMessage ( String message ) {
48 | /* Decodes motor command messages and generates response .
49 | *
50 | * Parameters :
51 | * | message ( String ): Data from motor message sent over serial from python .
52 | *
53 | * Returns :
54 | * | ( String ): message to be sent as a response
55 | */
56 | int pitch = message . substring (0 , 3) . toInt () ;
57 | int yaw = message . substring (4 , 7) . toInt () ;
58 | int waitTime = 15;
59 | setServoPosition ( pitch , yaw ) ;
60 | String response = String ( waitTime , DEC ) ;
61 | return response ;
62 | }

63

64 | void sendMessage ( char messageType , String messageData ) {
65 | /* Send a message to python using serial
66 | *
67 | * Parameters :
68 | * | messageType ( char ): the type of the message . Examples include , ’M’ for
69 | * | motor response , ’S’ for sensor response , or ’T’ for test .
70 | * messageData ( String ): the message data to be sent .
71 | */
72 | Serial . print ( messageType ) ;
73 | Serial . println ( messageData ) ;
74 | }

75
76 | void analyzeMessage ( String message ) {
77 | /* Decode serial messages from python and execute corresponding
78 | * response function and returns the response .
79 | *
80 | * Parameters :
81 | * | message ( String ): the raw message sent over serial from python .
82 | */
83 | char messageType = message . charAt ( TYPE_INDEX ) ;
84 | String data = message . substring ( DATA_INDEX ) ;
85 | String response ;
86 | switch ( messageType ) {
87 | | case ’M’:
88 | | response = respondServoMessage ( data ) ;
89 | | sendMessage (’M’, response ) ;
90 | | break ;
91 | | case ’S’:
92 | | response = respondSensorMessage ( data ) ;
93 | | sendMessage (’S’, response ) ;
94 | | break ;
95 | | case ’T’:
96 | | sendMessage (’T’, " 12345 ") ;
97 | | break ;
98 | }
99 | }

100
101 | void setup () {
102 | /* The setup function starts serial communcation , sets up a debug LED , and
103 | * assigns PWM pins to servos .
104 | */
105 | Serial . begin (115200) ;
106 | Serial . flush () ;
107 | pinMode ( LED_BUILTIN , OUTPUT ) ;
108 | digitalWrite ( LED_BUILTIN , LOW ) ;

109
110 | pitchServo . attach ( PITCH_SERVO_PIN ) ;
111 | yawServo . attach ( YAW_SERVO_PIN ) ;
112 | current_pitch = 0;
113 | current_yaw = 0;
114 | setServoPosition ( current_pitch , current_yaw ) ;
115 | }

116
117 | void loop () {
118 | /* The main loop reads incoming serial messages and sends them
119 | * to the analyzeMessage function where they are decoded and the
120 | * proper actions are taken .
121 | */
122 | if ( Serial . available () > 0) {

123 | digitalWrite ( LED_BUILTIN , HIGH ) ;
124 | String message = Serial . readStringUntil (’\n’) ;
125 | analyzeMessage ( message ) ;
126 | } else {
127 | digitalWrite ( LED_BUILTIN , LOW ) ;
128 | }
129 | }

## 2 Results

Figure 16 shows the final scan we took which included filtering and averaging the data to create a clean image. We performed this scan at a higher resolution (roughly twice what we were using before). While the measurements are not very accurate due to small inaccuracies in the calibration, bad data read from the sensor, and the convolution filter; the shape of the letter is very clear which is ultimately what we wanted to achieve.

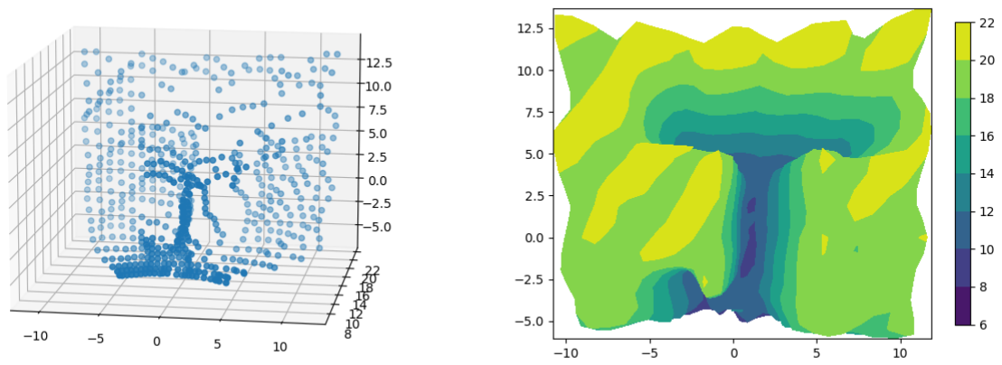
[picture p17: figure]

Figure 16: A high resolution (25 point by 25 point) scan of the letter J against a wall with filtering.

## 3 Analysis

We can now see the letter J displayed in the python visualization software that we made. There are some inconsistencies, and there are slopping artifacts caused by the convolution filter, but otherwise, the letter is very clear and well depicted. The mechanism itself was pretty smooth, at times it would wiggle but it was reliable for the most part. One way we could try to improve the image quality is to change the type of filtering we are performing on the data which alters the data less than the convolution filter while still removing the noise.

## 4 Conclusion and Reflection

During this project, we believe that we did a very good job of focusing on the integration aspect of the project rather than going our separate ways. We assisted each other to help learn things

### that we had wanted to learn and support each other. Everyone was fully aware of what was

going on, and there was clear communication. In our first meeting, we made sure to lay down our expectations/goals/strengths/weaknesses for this project so that we were all on the same page. We prioritized the Python and Arduino communication and used VScode so that all team members were contributing/understanding the code. We had a very good scaffolding, which made it extremely easy to execute the actual scan once the framework was integrated. Overall we’re super proud of

### the results!
