nonas-hunter/3D-scanner/docs/results/result_2.png

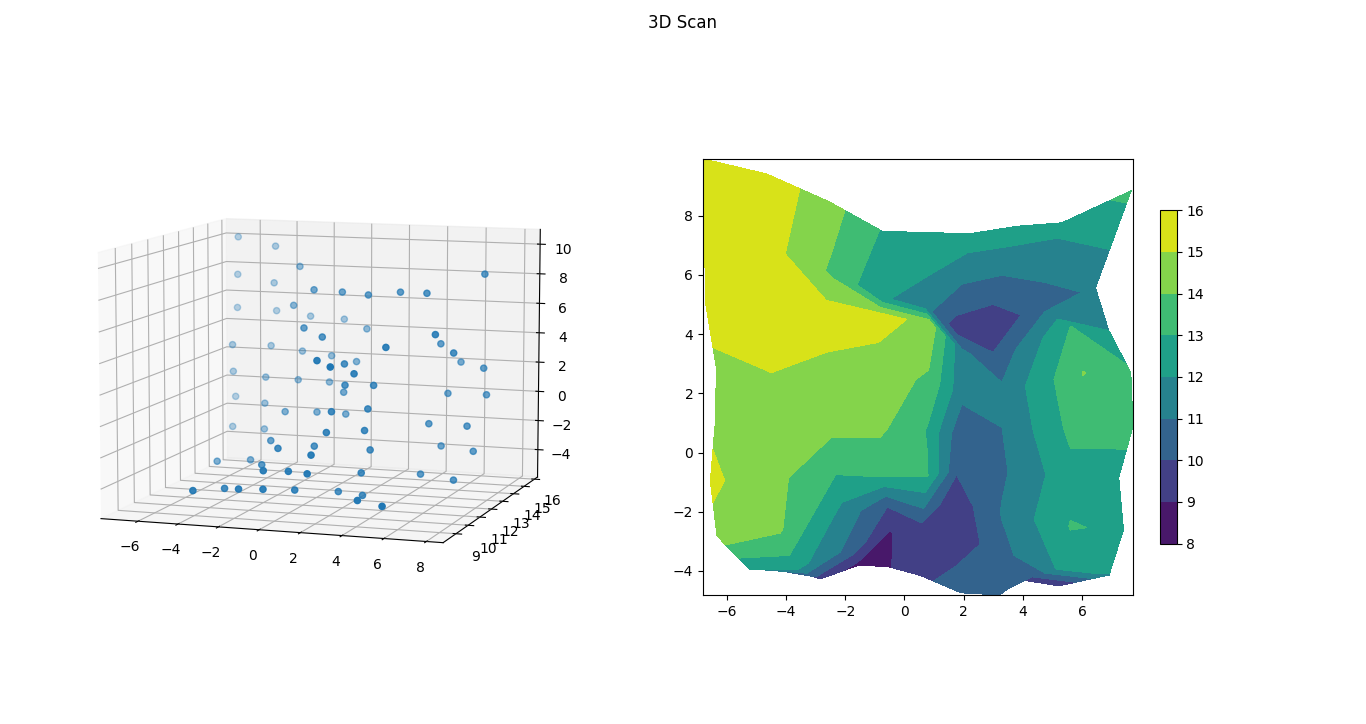
docs/results/result_2.png
