nonas-hunter/3D-scanner/docs/results/result_3.png

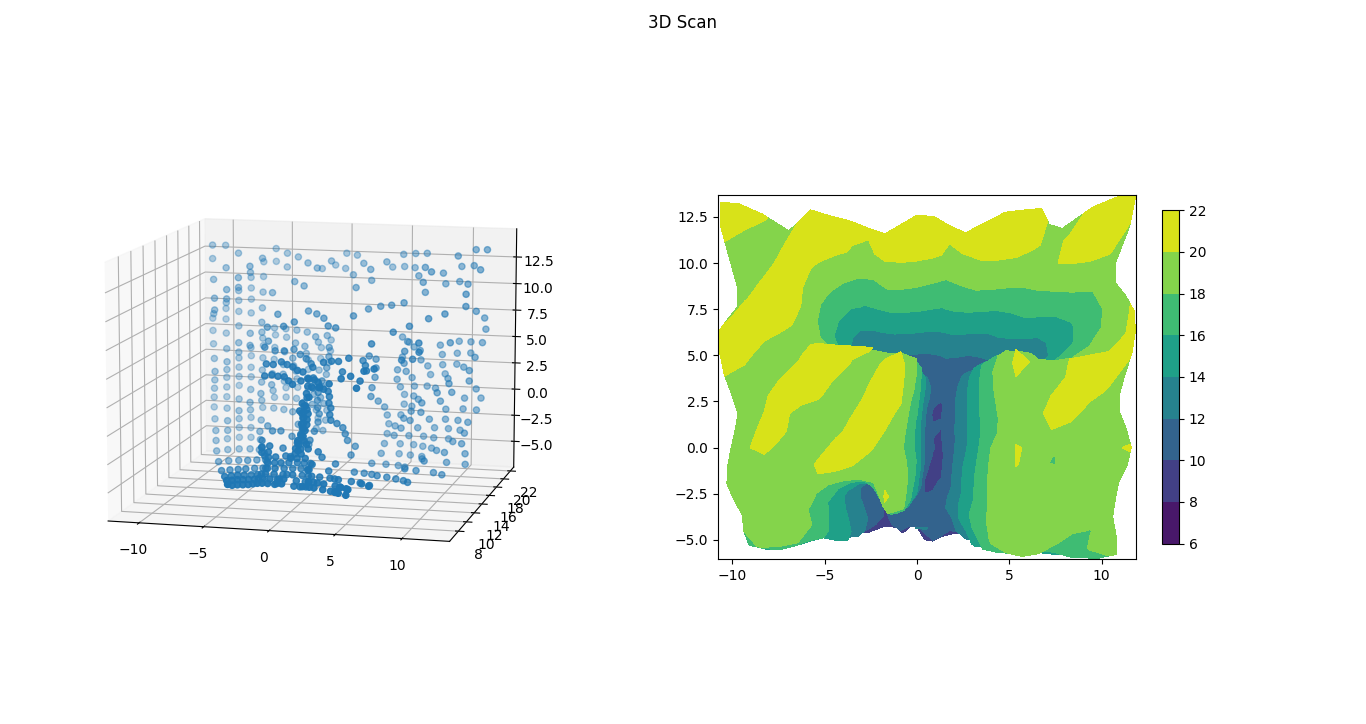
docs/results/result_3.png
