nonas-hunter/3D-scanner/docs/results/result_6.png

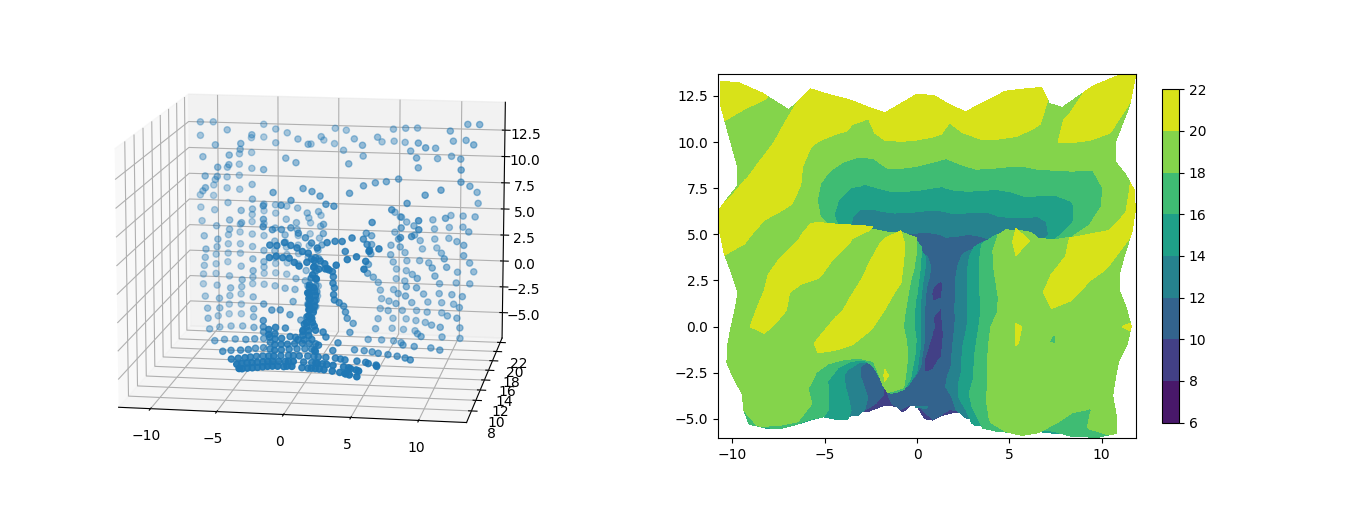
docs/results/result_6.png
