nonas-hunter/3D-scanner/(commit log)

2021-09-22 Inital connection to one servo
2021-09-24 Add current arduino code to repo (unorganized)
2021-09-27 Turn motors based on message data
2021-09-28 Start writting send motor data function
2021-09-28 Add functionality to set servo position
2021-09-28 Add respond function for sensor messages
2021-09-29 Update pin numbers
2021-09-29 Make it possible to pass pitch and yaw data through function params
2021-09-29 Edit test files to perform calibration
2021-09-29 Create separate arduino file for testing
2021-09-29 Read three sensor values at a time
2021-09-30 Apply convolution filtering to final image
